Lukelectro/jongleerkegel/bezier_polygon.scad

points = [[0,0],[10,5],[0,25]];

curvepoints = [for (i=[0:0.05:1]) bezier(points,i) ];

polygon(curvepoints);    

// Quadratic Bezier curve rastering
// Aart 09-2018 Aartsite.nl
    function bezier (P,t) =
        let(
                x1 = P[0][0] + (( P[1][0] - P[0][0]) *t),
                y1 = P[0][1] + (( P[1][1] - P[0][1]) *t),
                x2 = P[1][0] + (( P[2][0] - P[1][0]) *t),
                y2 = P[1][1] + (( P[2][1] - P[1][1]) *t),
                x=x1+((x2-x1)*t),
                y=y1+((y2-y1)*t)
                ) ([x,y]);
