Lukelectro/jongleerkegel/(list of files, cad)

Other CAD files:
grapje.scad
