Lukelectro/jongleerkegel/(commit log)

2026-02-12 modificeer de Beziercurve van Aartsite om een polygon op te leveren ipv ge-translate objecten
    [bezier_polygon.scad]
2026-02-12 en maak daar een jongleerkegel mee
    [jongleerkegel.scad]
2026-02-12 Met echt een handvat en een knop en alles
    [jongleerkegel.scad]
2026-02-12 hol zodat er een stok door het midden kan, zoals bij commercieel verkrijgbare meerdelige jongleerkegels. Parametrisch, .json voor de customizer
    [grapje.scad, jongleerkegel.scad]
2026-02-12 meer customizer opties voor de vorm van de fles
    [jongleerkegel.scad]
2026-02-12 Bestand met los de flesvorm, duidelijker wanneer het echt de vorm van een jongleerkegel-'bulb' heeft
    [bottlebit_in_seperate_file.scad]
2026-02-12 default de standaardvorm (0) kiezen. Comments een beetje bijgewerkt
    [bottlebit_in_seperate_file.scad, jongleerkegel.scad]
2026-03-08 add strengthening edge / anti-stress edge. Choose smaller rotate_extrude angle to view
    [jongleerkegel.scad]
2026-03-08 makes lower end of handle diameter and top of bottle diameter independent, so top of bottle can be wide enought to accept batteries/electronics etc bolted to sides of dowel
    [jongleerkegel.scad]
2026-08-02 customized to fit in a backpak
    [jongleerkegel.scad]
2026-08-20 jongleerkegel_fits_backpack: middle bit did not fit, so add a taper an lengthen middle ring
    [jongleerkegel.scad]
2026-08-20 drill jig to dril in the center of the wooden rod
    [drilljig.scad]
2026-08-21 inset handle a bit more into knob
    [jongleerkegel.scad]
2026-08-22 Weight distribution turned out fine for the fitsbackpack config: a little low / below the middle bit, but juggle-able. Settings for preview and render are already different, en een klein schaalmodel 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
    [jongleerkegel.scad]
2026-08-22 bottom puck square because printing the round one gave stringing on overhangs, SHD no longer a global parameter
    [jongleerkegel.scad]
2026-08-23 middle bit taps toelopend, betere preview (ook geassembleerd)
    [jongleerkegel.scad]
2026-09-02 holes in bottom puck (top) for more flexibility, as it originally was too rigid / massive.
    [jongleerkegel.scad]
2026-09-02 bottom puck (top) even less masive
    [jongleerkegel.scad]
2026-09-02 bottom puck (top) even less masive - angled all holes now
    [jongleerkegel.scad]
2026-09-05 echo dowel length and total length ; cleanup of notes / explanation
    [jongleerkegel.scad]
2026-09-05 playing with parameters a bit
    [jongleerkegel.scad]
2026-10-06 Trying to make top knob squishy-er in Z direction, added colors and cutouts for clearer preview
    [jongleerkegel.scad]
